kolisahil2709/CAPSTONE-2026/ESP32_S3_Attendance_System_Schematic.pdf

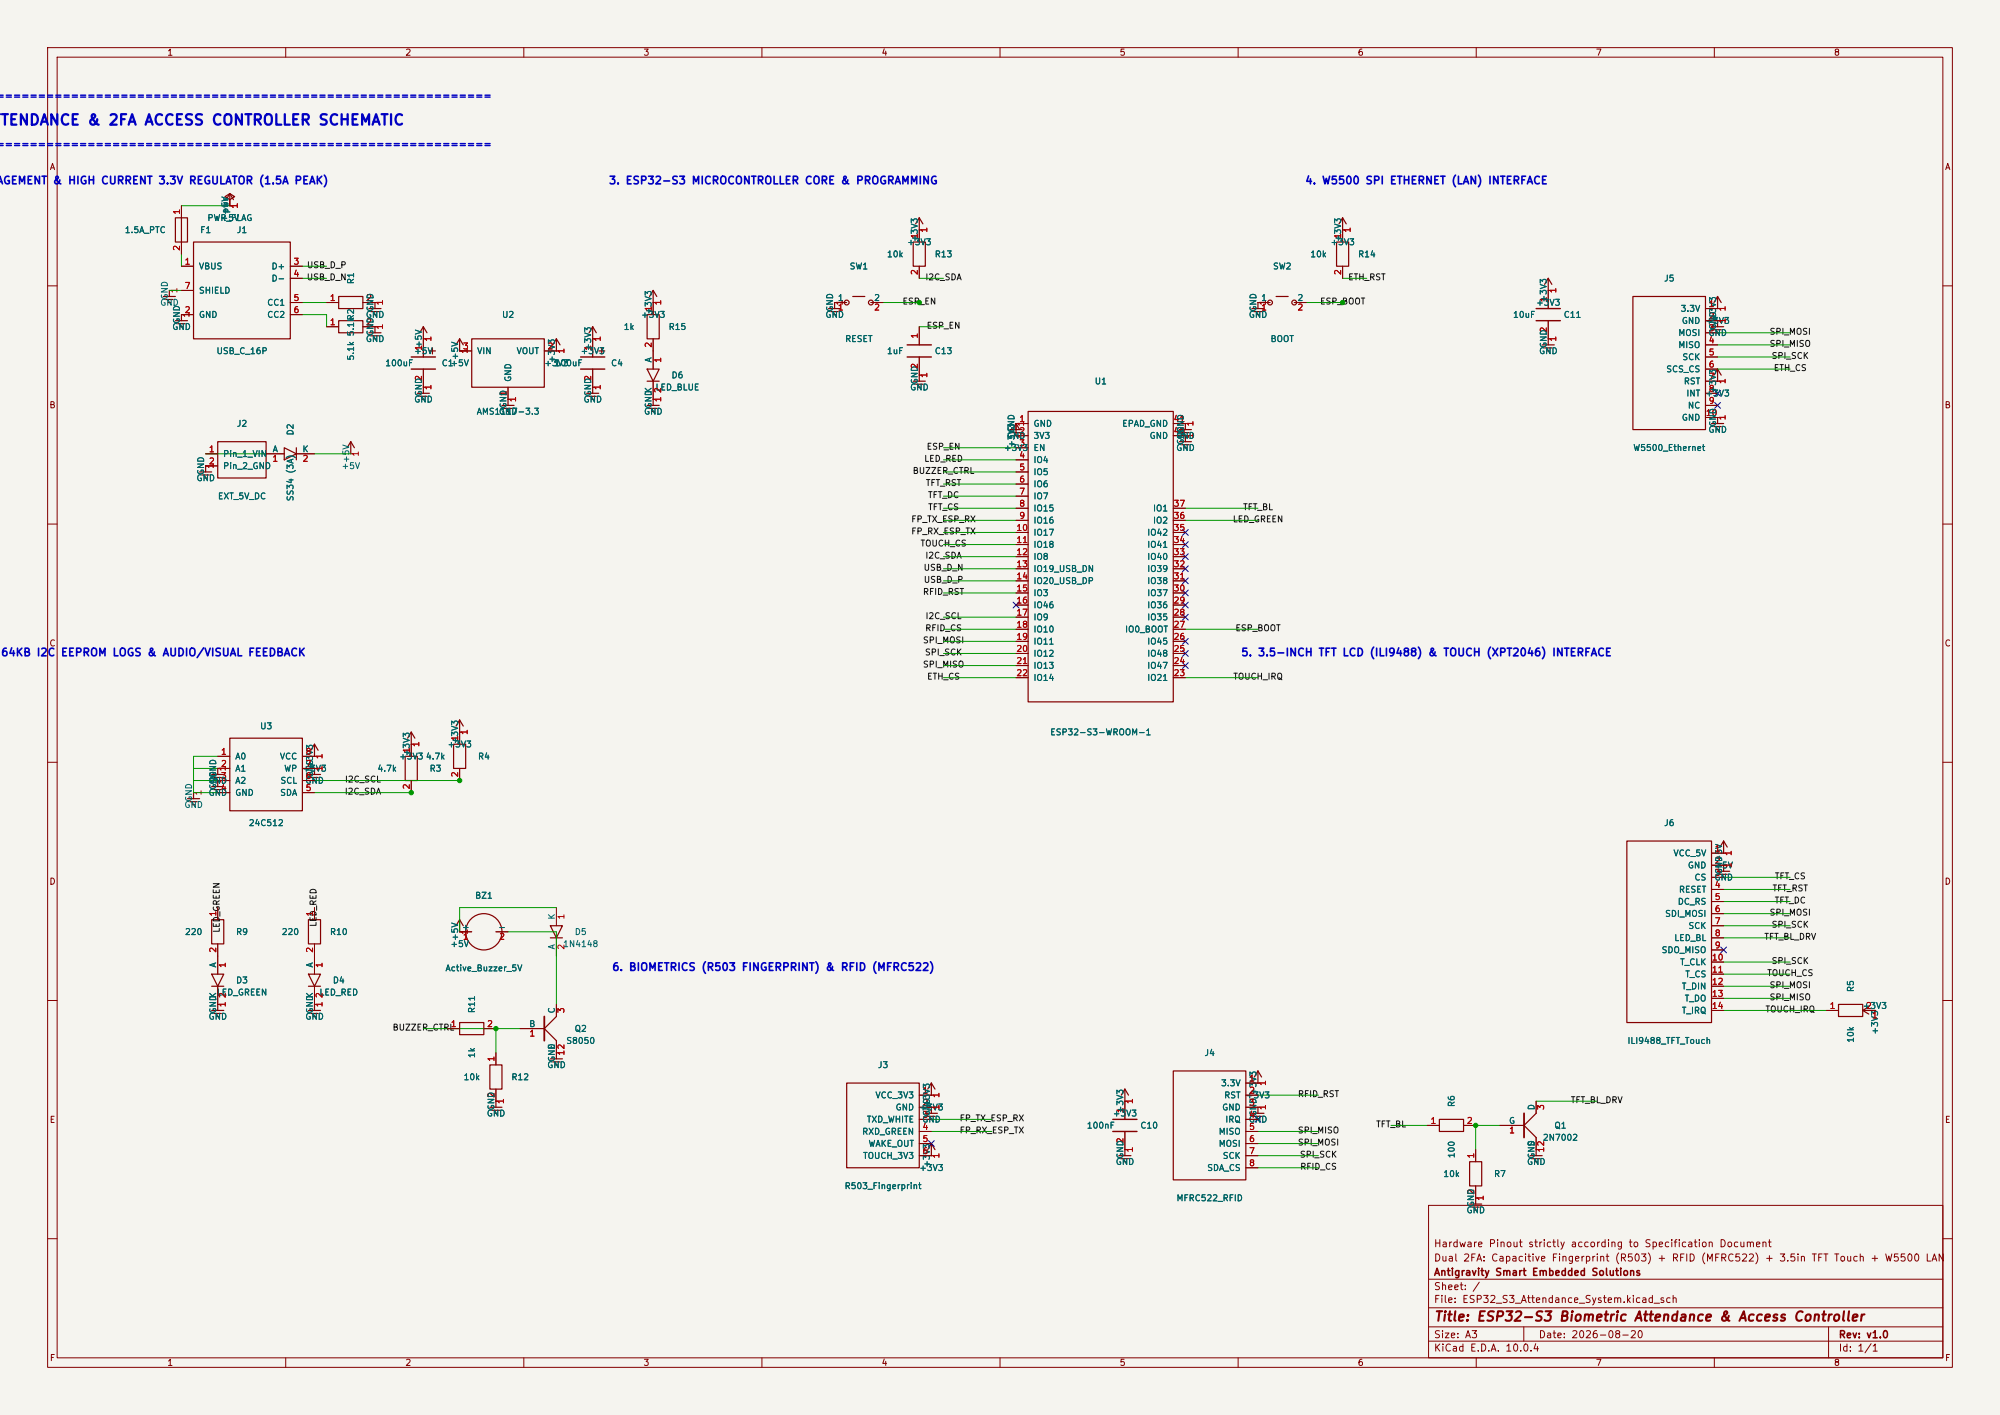
[picture p1: page 1]

1. POWER MANAGEMENT & HIGH CURRENT 3.3V REGULATOR (1.5A PEAK)

SW2 BOOT 2
Hardware Pinout strictly according to Specification Document +3V3

Dual 2FA: Capacitive Fingerprint (R503) + RFID (MFRC522) + 3.5in TFT Touch + W5500 LAN
Antigravity Smart Embedded Solutions
Sheet: /
File: ESP32_S3_Attendance_System.kicad_sch
Title: ESP32-S3 Biometric Attendance & Access Controller

Size: A3 | Rev: v1.0
KiCad E.D.A. 10.0.4 | Id: 1/1 | F Date: 2026-08-20
