kolisahil2709/CAPSTONE-2026/ESP32_S3_Attendance_System.kicad_sch

## KiCad design ESP32_S3_Attendance_System.kicad_sch (2026-09-10)

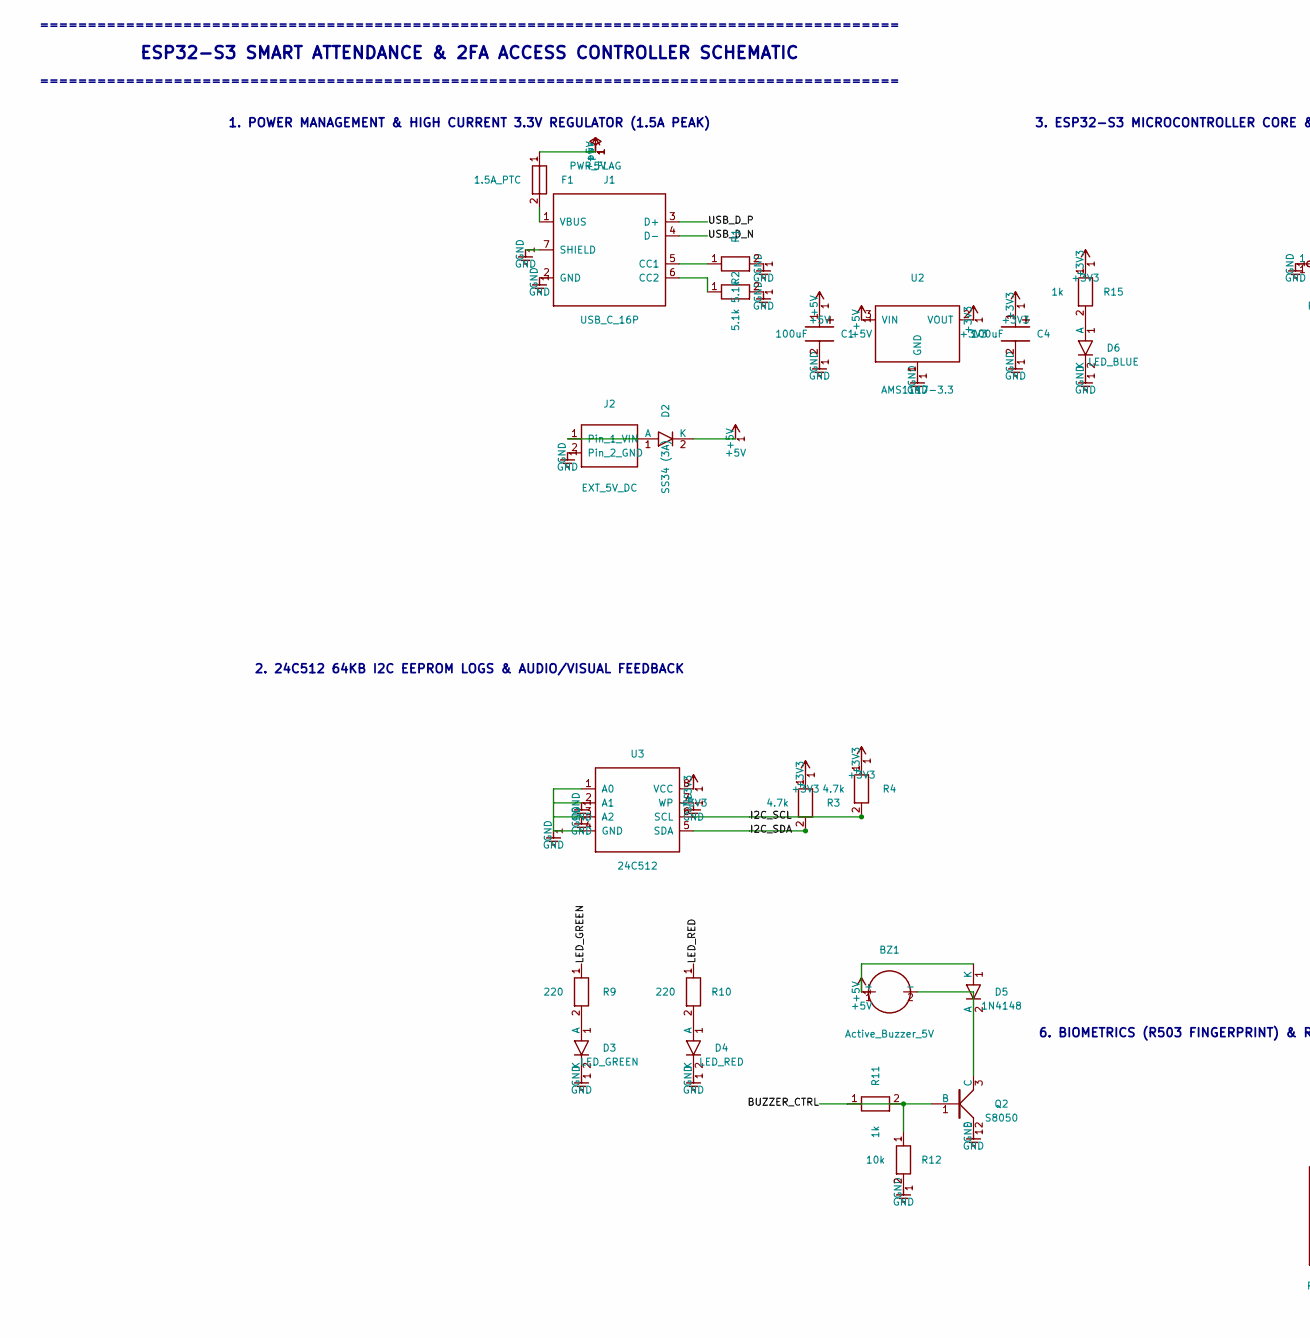
[picture p2: schematic ESP32_S3_Attendance_System.kicad_sch, part in row 1, column 1]

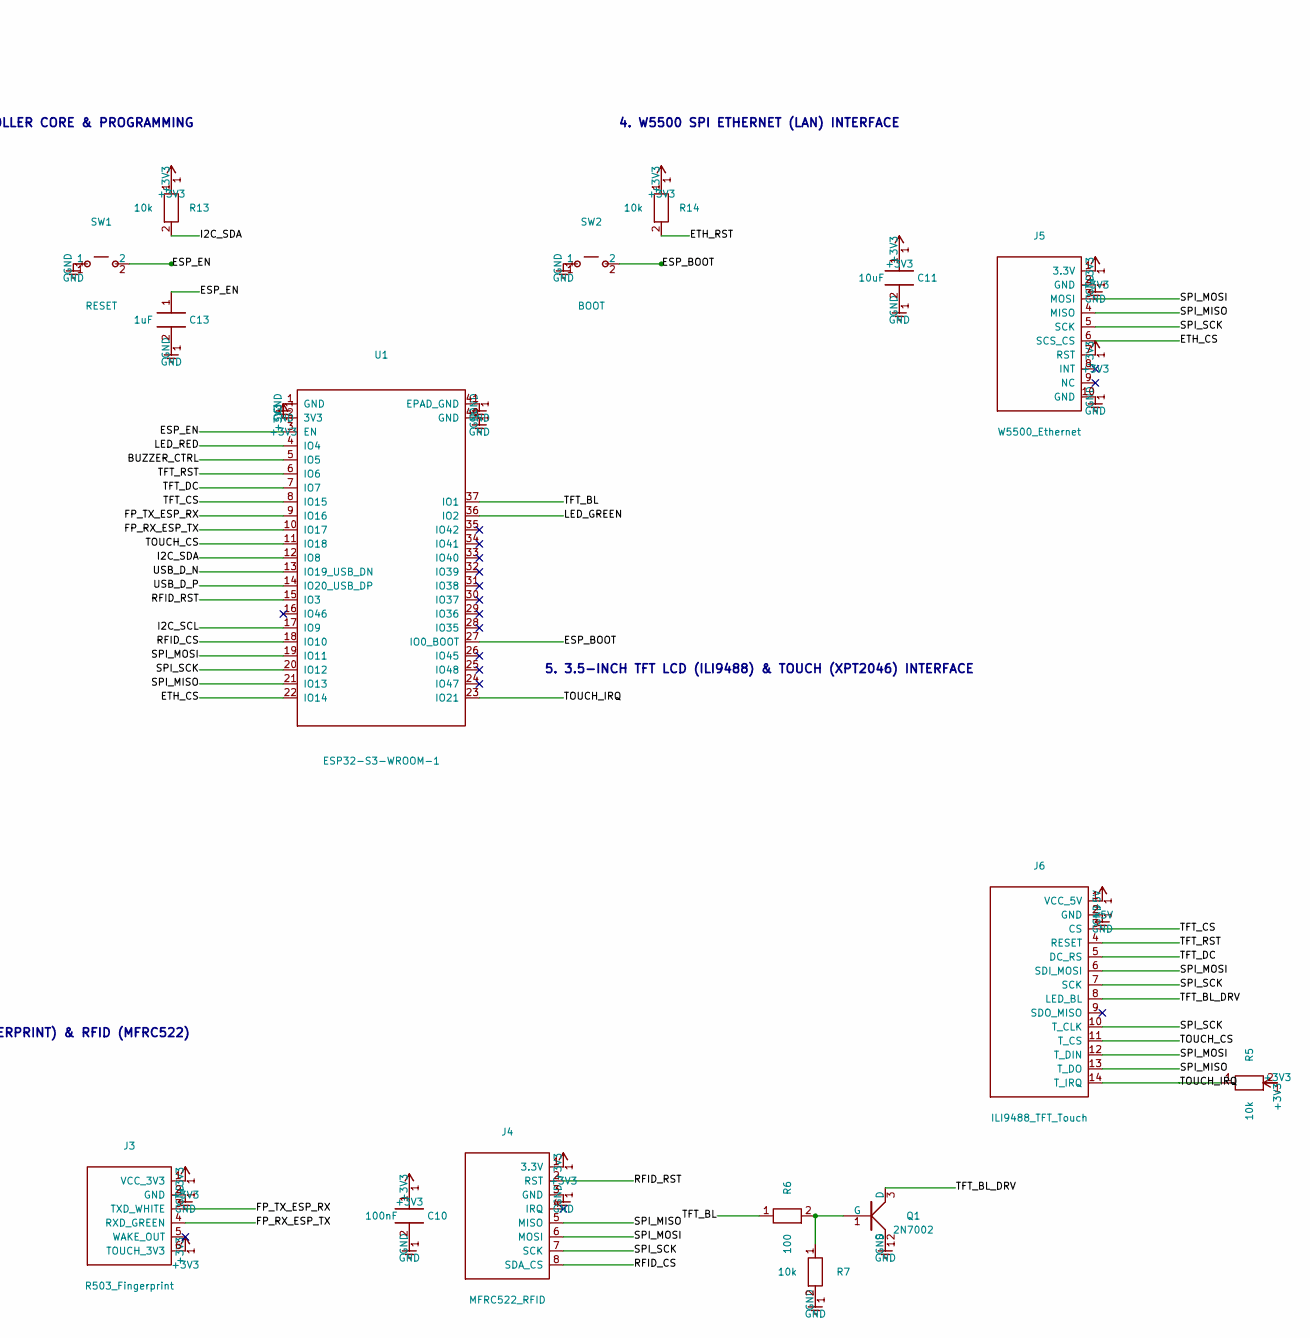
[picture p3: schematic ESP32_S3_Attendance_System.kicad_sch, part in row 1, column 2]

Parts:
BZ1: Active_Buzzer_5V; Buzzer_12x9.5RM7.6
C1, C4: 100uF; CP_EIA-7343-31_Kemet-D
C10: 100nF; C_0805_2012Metric
C11: 10uF; C_0805_2012Metric
C13: 1uF; C_0805_2012Metric
D2: SS34 (3A); D_SMA
D3: LED_GREEN; LED_0805_2012Metric
D4: LED_RED; LED_0805_2012Metric
D5: 1N4148; D_SOD-123
D6: LED_BLUE; LED_0805_2012Metric
F1: 1.5A_PTC; Fuse_1812_4532Metric
J1: USB_C_16P; USB_C_Receptacle_Palconn_UTC16-G
J2: EXT_5V_DC; TerminalBlock_bornier-2_P5.08mm
J3: R503_Fingerprint; JST_SH_SM06B-SRSS-TB_1x06-1MP_P1.00mm
J4: MFRC522_RFID; PinHeader_1x08_P2.54mm_Vertical
J5: W5500_Ethernet; PinHeader_1x10_P2.54mm_Vertical
J6: ILI9488_TFT_Touch; PinHeader_1x14_P2.54mm_Vertical
Q1: 2N7002; SOT-23
Q2: S8050; SOT-23
R1, R2: 5.1k; R_0805_2012Metric
R3, R4: 4.7k; R_0805_2012Metric
R5, R7, R12, R13, R14: 10k; R_0805_2012Metric
R6: 100; R_0805_2012Metric
R9, R10: 220; R_0805_2012Metric
R11, R15: 1k; R_0805_2012Metric
SW1: RESET; SW_Push_SPST_NO_Alps_SKHH_Series
SW2: BOOT; SW_Push_SPST_NO_Alps_SKHH_Series
U1: ESP32-S3-WROOM-1
U2: AMS1117-3.3; SOT-223-3_TabPin2
U3: 24C512; SOIC-8_3.9x4.9mm_P1.27mm

Connections:
+3V3: C4.1, C10.1, C11.1, J3.1 (VCC_3V3), J3.6 (TOUCH_3V3), J4.1 (3.3V), J5.1 (3.3V), J5.7 (RST), R3.1, R4.1, R5.2, R13.1, R14.1, R15.1, U1.2 (3V3), U2.2 (VOUT), U3.8 (VCC)
+5V: BZ1.1 (+), C1.1, D2.2 (K), D5.1 (K), F1.1, J6.1 (VCC_5V), U2.3 (VIN)
BUZZER_CTRL: Q2.1 (B), R11.1, R11.2, R12.1, U1.5 (IO5)
ESP_BOOT: SW2.2, U1.27 (IO0_BOOT)
ESP_EN: C13.1, SW1.2, U1.3 (EN)
ETH_CS: J5.6 (SCS_CS), U1.22 (IO14)
ETH_RST: R14.2
FP_RX_ESP_TX: J3.4 (RXD_GREEN), U1.10 (IO17)
FP_TX_ESP_RX: J3.3 (TXD_WHITE), U1.9 (IO16)
GND: C1.2, C4.2, C10.2, C11.2, C13.2, D3.2 (K), D4.2 (K), D6.2 (K), J1.2 (GND), J1.7 (SHIELD), J2.2 (Pin_2_GND), J3.2 (GND), J4.3 (GND), J5.2 (GND), J5.10 (GND), J6.2 (GND), Q1.2 (S), Q2.2 (E), R1.2, R2.2, R7.2, R12.2, SW1.1, SW2.1, U1.1 (GND), U1.40 (GND), U1.41 (EPAD_GND), U2.1 (GND), U3.1 (A0), U3.2 (A1), U3.3 (A2), U3.4 (GND), U3.7 (WP)
I2C_SCL: R4.2, U1.17 (IO9), U3.6 (SCL)
I2C_SDA: R3.2, R13.2, U1.12 (IO8), U3.5 (SDA)
LED_GREEN: R9.1, U1.36 (IO2)
LED_RED: R10.1, U1.4 (IO4)
unnamed: BZ1.2 (-), D5.2 (A), Q2.3 (C)
unnamed: D2.1 (A), J2.1 (Pin_1_VIN)
unnamed: D3.1 (A), R9.2
unnamed: D4.1 (A), R10.2
unnamed: D6.1 (A), R15.2
unnamed: F1.2, J1.1 (VBUS)
unnamed: J1.5 (CC1), R1.1
unnamed: J1.6 (CC2), R2.1
unnamed: Q1.1 (G), R6.2, R7.1
RFID_CS: J4.8 (SDA_CS), U1.18 (IO10)
RFID_RST: J4.2 (RST), U1.15 (IO3)
SPI_MISO: J4.5 (MISO), J5.4 (MISO), J6.13 (T_DO), U1.21 (IO13)
SPI_MOSI: J4.6 (MOSI), J5.3 (MOSI), J6.6 (SDI_MOSI), J6.12 (T_DIN), U1.19 (IO11)
SPI_SCK: J4.7 (SCK), J5.5 (SCK), J6.7 (SCK), J6.10 (T_CLK), U1.20 (IO12)
TFT_BL: R6.1, U1.37 (IO1)
TFT_BL_DRV: J6.8 (LED_BL), Q1.3 (D)
TFT_CS: J6.3 (CS), U1.8 (IO15)
TFT_DC: J6.5 (DC_RS), U1.7 (IO7)
TFT_RST: J6.4 (RESET), U1.6 (IO6)
TOUCH_CS: J6.11 (T_CS), U1.11 (IO18)
TOUCH_IRQ: J6.14 (T_IRQ), R5.1, U1.23 (IO21)
USB_D_N: J1.4 (D-), U1.13 (IO19_USB_DN)
USB_D_P: J1.3 (D+), U1.14 (IO20_USB_DP)

Notes on the sheet:
==========================================================================================
ESP32-S3 SMART ATTENDANCE & 2FA ACCESS CONTROLLER SCHEMATIC
1. POWER MANAGEMENT & HIGH CURRENT 3.3V REGULATOR (1.5A PEAK)
2. 24C512 64KB I2C EEPROM LOGS & AUDIO/VISUAL FEEDBACK
3. ESP32-S3 MICROCONTROLLER CORE & PROGRAMMING
4. W5500 SPI ETHERNET (LAN) INTERFACE
5. 3.5-INCH TFT LCD (ILI9488) & TOUCH (XPT2046) INTERFACE
6. BIOMETRICS (R503 FINGERPRINT) & RFID (MFRC522)
