kolisahil2709/CAPSTONE-2026/Attendance_System/html_page_gz.h

#pragma once
#include <Arduino.h>

const uint32_t index_html_gz_len = 53595;
const uint8_t index_html_gz[] PROGMEM = {
    0x1f, 0x8b, 0x08, 0x00, 0x00, 0x00, 0x00, 0x00, 0x02, 0xff, 0xec, 0xbd, 0x6b, 0x73, 0x23, 0x49,
    0x92, 0x18, 0xf8, 0x9d, 0xbf, 0x22, 0x1b, 0x6d, 0x3d, 0x04, 0xa6, 0x09, 0x10, 0x00, 0x09, 0x16,
    0x8b, 0xac, 0xe2, 0x88, 0x4d, 0xb2, 0xaa, 0x38, 0xc3, 0x2a, 0x52, 0x24, 0xab, 0x5b, 0x7d, 0x3d,
    0x6d, 0x63, 0x20, 0x90, 0x20, 0x72, 0x0a, 0xaf, 0xc3, 0xa3, 0xaa, 0xb9, 0xbd, 0x25, 0xdb, 0x95,
    0x9d, 0xa4, 0x93, 0x6e, 0x75, 0xd2, 0xcc, 0xb6, 0x6e, 0x6f, 0x47, 0x67, 0x37, 0x7b, 0x66, 0x2b,
    0x93, 0x6c, 0x4d, 0x67, 0x26, 0x33, 0x99, 0x64, 0xa7, 0x2f, 0xf7, 0xe1, 0x7e, 0x4a, 0xff, 0x81,
    0xdb, 0x9f, 0x70, 0xfe, 0x88, 0x77, 0x46, 0x64, 0x26, 0xc0, 0xaa, 0xea, 0x5e, 0xdd, 0xcc, 0xa3,
    0x88, 0xcc, 0x8c, 0x87, 0x87, 0x87, 0x87, 0x87, 0x87, 0x87, 0x3f, 0x1e, 0x7d, 0x74, 0x7c, 0x7e,
    0x74, 0xfd, 0xe5, 0xc5, 0x49, 0xd4, 0x9f, 0x0f, 0x07, 0x07, 0x6b, 0x8f, 0xf0, 0x4f, 0x34, 0x68,
    0x8f, 0x6e, 0x1f, 0x97, 0xe2, 0x51, 0x29, 0xea, 0xb6, 0xe7, 0xed, 0xea, 0xbc, 0x1f, 0x0f, 0xe3,
    0xc7, 0xa5, 0x41, 0x72, 0xdb, 0x9f, 0x97, 0xb0, 0x4c, 0xdc, 0xee, 0xc2, 0x9f, 0x61, 0x3c, 0x6f,
    0x47, 0x9d, 0x7e, 0x7b, 0x3a, 0x8b, 0xe7, 0x8f, 0x4b, 0x2f, 0xaf, 0x9f, 0x54, 0x77, 0x4b, 0xf2,
    0xf5, 0xa8, 0x8d, 0x35, 0x5e, 0x27, 0xf1, 0x9b, 0xc9, 0x78, 0x3a, 0x2f, 0x45, 0x9d, 0xf1, 0x68,
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
    0x65, 0xb7, 0x35, 0x2e, 0xc7, 0xb0, 0x84, 0x46, 0xfa, 0x0f, 0xb9, 0x39, 0x4b, 0x6f, 0x5d, 0x1a,
    0x7d, 0x25, 0xf6, 0x25, 0x9e, 0x00, 0x56, 0xb7, 0xad, 0x7c, 0x7f, 0x59, 0x50, 0x16, 0x85, 0x77,
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
};
