kolisahil2709/CAPSTONE-2026/(commit log)

2026-07-22 Add Employee modal, Post-Creation Hardware Enrollment, and Factory Reset fixes
    [html_page_gz.h, sql_bridge.py, web_routes.ino]
2026-07-22 Fix /get-sql-history proxy route and hasData flag for transaction records
    [html_page_gz.h, web_routes.ino]
2026-07-22 Fix login authentication API parameter parsing and session cookie initialization
    [html_page_gz.h, web_routes.ino]
2026-07-22 Fix login authentication handler and bypass authentication block on ESP32
    [html_page_gz.h, web_routes.ino]
2026-07-22 Bypass login screen block on button click and auto-enter dashboard on page load
2026-09-10 Initial commit: ESP32-S3 Attendance System PCB project
